VermeulenKirsten/Project1/Coding/templates/img/jpg/ParcelLocker.jpg

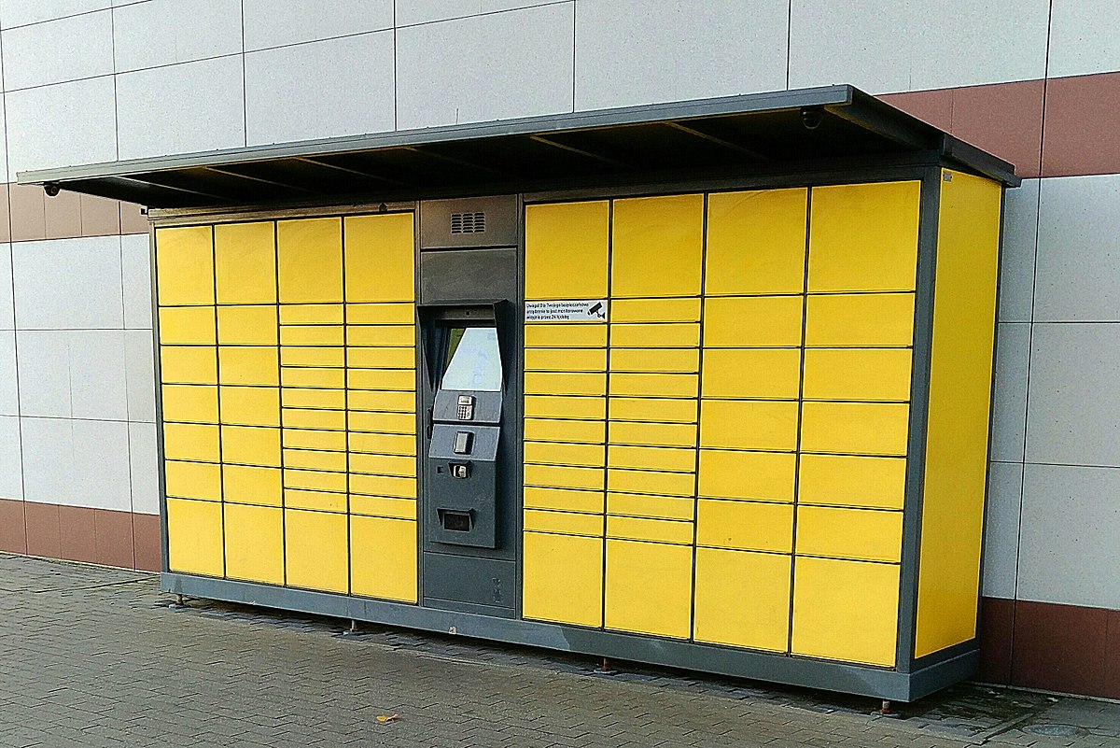
Coding/templates/img/jpg/ParcelLocker.jpg
