VermeulenKirsten/Project1/Coding/templates/img/jpg/user.jpg

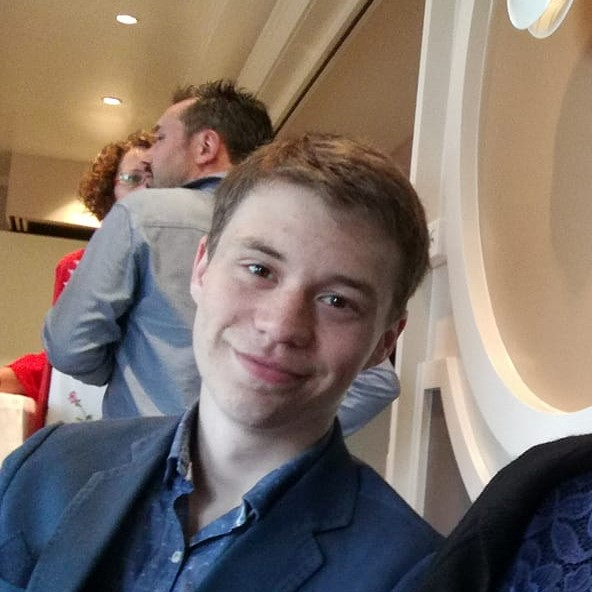
Coding/templates/img/jpg/user.jpg
