VermeulenKirsten/Project1/Milestone 4 Vormstudie/Vormstudie.docx

Vormstudie & productontwikkeling

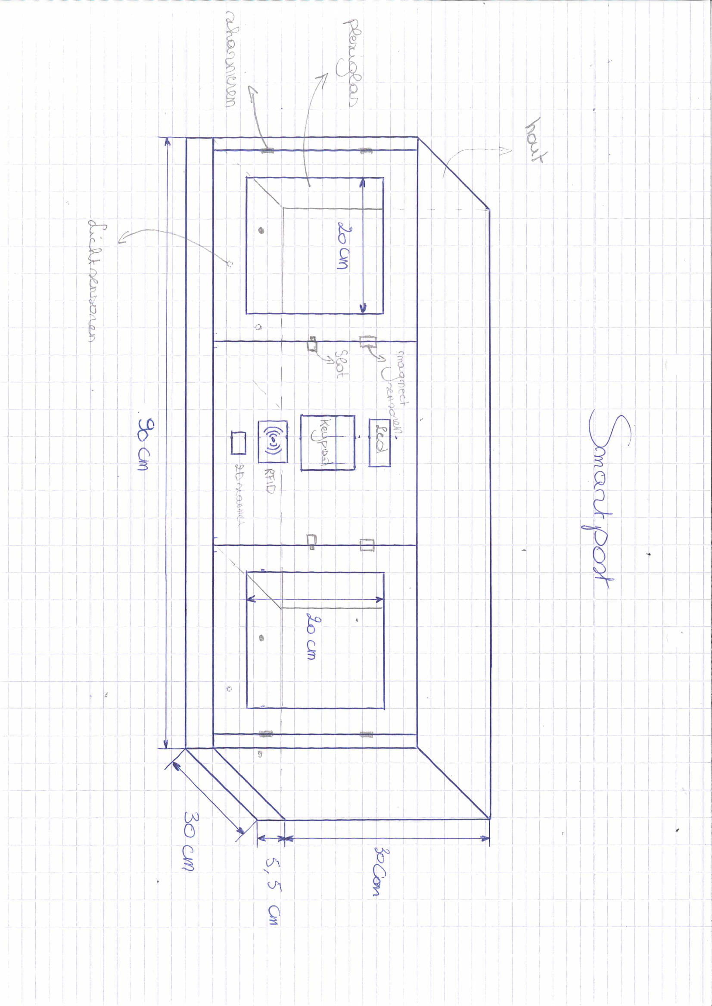
[picture p3: figure]

# Technieken

1. Verzagen
2. Verlijmen
3. lasercutten
