VermeulenKirsten/Project1/Deliverables/Final_poster.pdf

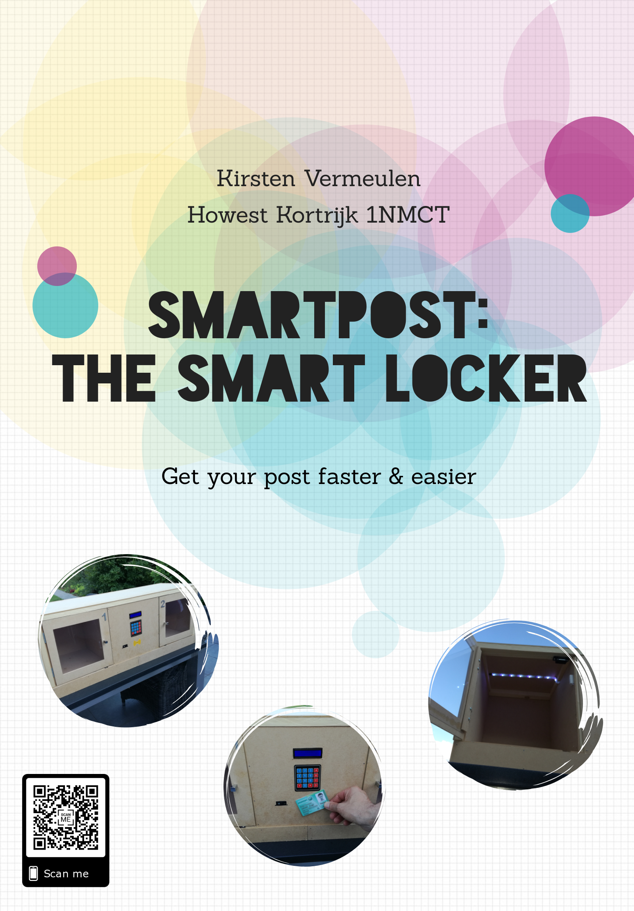
[picture p15: page 1]
