VermeulenKirsten/Project1/Deliverables/Toggl_summary_report.pdf

# Summary Report

### February 13, 2019 – June 17, 2019

TOTAL HOURS: 214:21:25

63.9 h

51.1 h

38.3 h

25.6 h

12.8 h

0.0 h

65:11

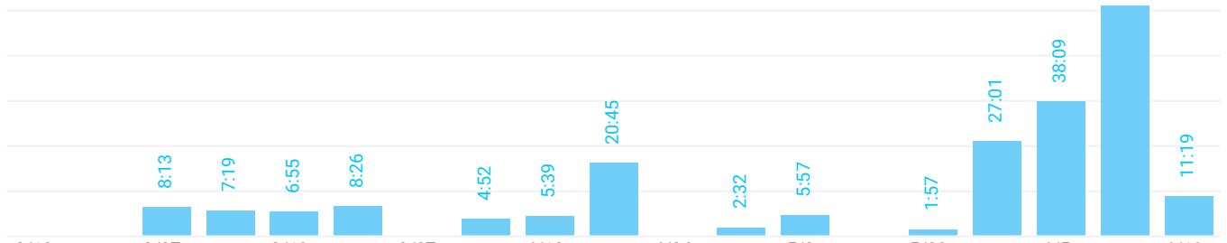
[picture p16: figure]

2/13 -
2/19

2/27 -
3/5

3/13 -
3/19

3/27 -
4/2

4/10 -
4/16

4/24 -
4/30

5/8 -
5/14

5/22 -
5/28

6/5 -
6/11

6/19 -
6/25

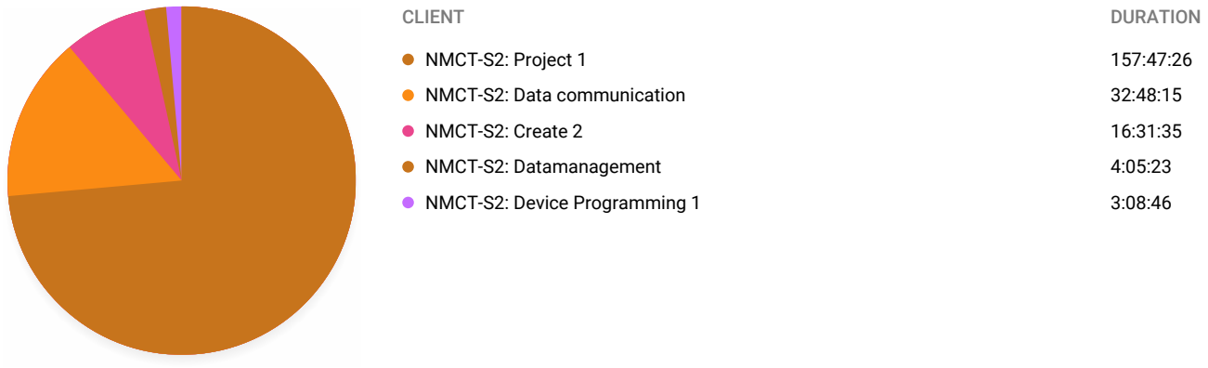
[picture p17: figure]
CLIENT; DURATION; NMCT-S2: Project 1; NMCT-S2: Data communication; NMCT-S2: Create 2; NMCT-S2: Datamanagement; NMCT-S2: Device Programming 1
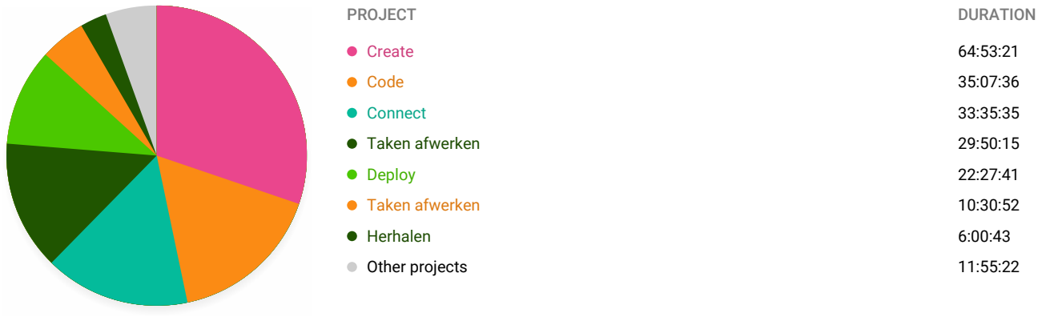
[picture p18: figure]
PROJECT; DURATION; Create; Code; Connect; Taken afwerken; Deploy; Herhalen; Other projects

Kirsten Vermeulen's workspace | Page 1/2

NMCT-S2: Create 2 | 16:31:35
Herhalen | 6:00:43
Taken afwerken | 10:30:52
NMCT-S2: Data communication | 32:48:15
Herhalen | 2:58:00
Taken afwerken | 29:50:15
NMCT-S2: Datamanagement | 4:05:23
Taken afwerken | 4:05:23
NMCT-S2: Device Programming 1 | 3:08:46
Herhalen | 3:08:46
NMCT-S2: Project 1 | 157:47:26
Code | 35:07:36
Connect | 33:35:35
Consult | 1:43:13
Create | 64:53:21
Deploy | 22:27:41
Created with toggl.com | Page 2/2
CLIENT - PROJECT | DURATION

Kirsten Vermeulen's workspace
