VermeulenKirsten/Project1/Milestone 1 Fritzing/Final_Fritzing_Breadboard.pdf

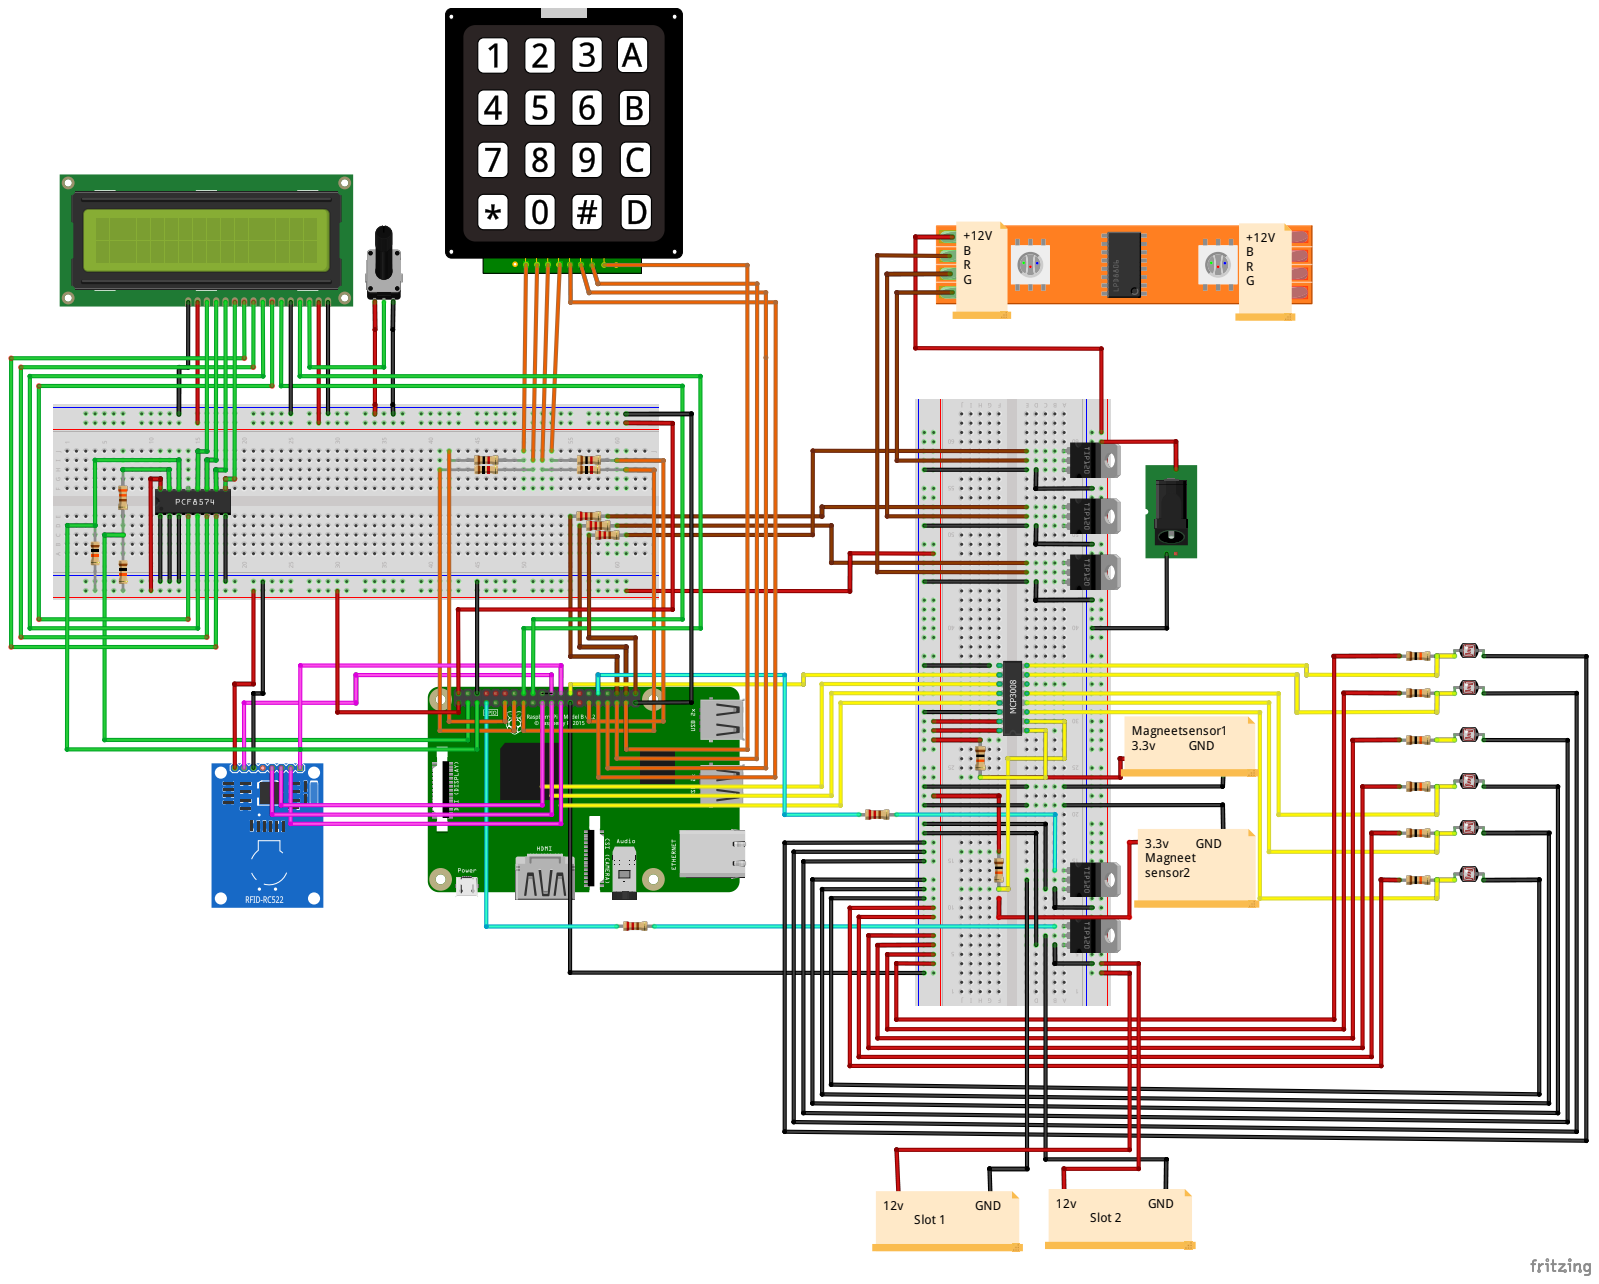
[picture p19: page 1]
Magneetsensor1; GND; Magneet sensor2; Slot 2; Slot 1
