VermeulenKirsten/Project1/Milestone 1 Fritzing/Final_Fritzing_Schema.pdf

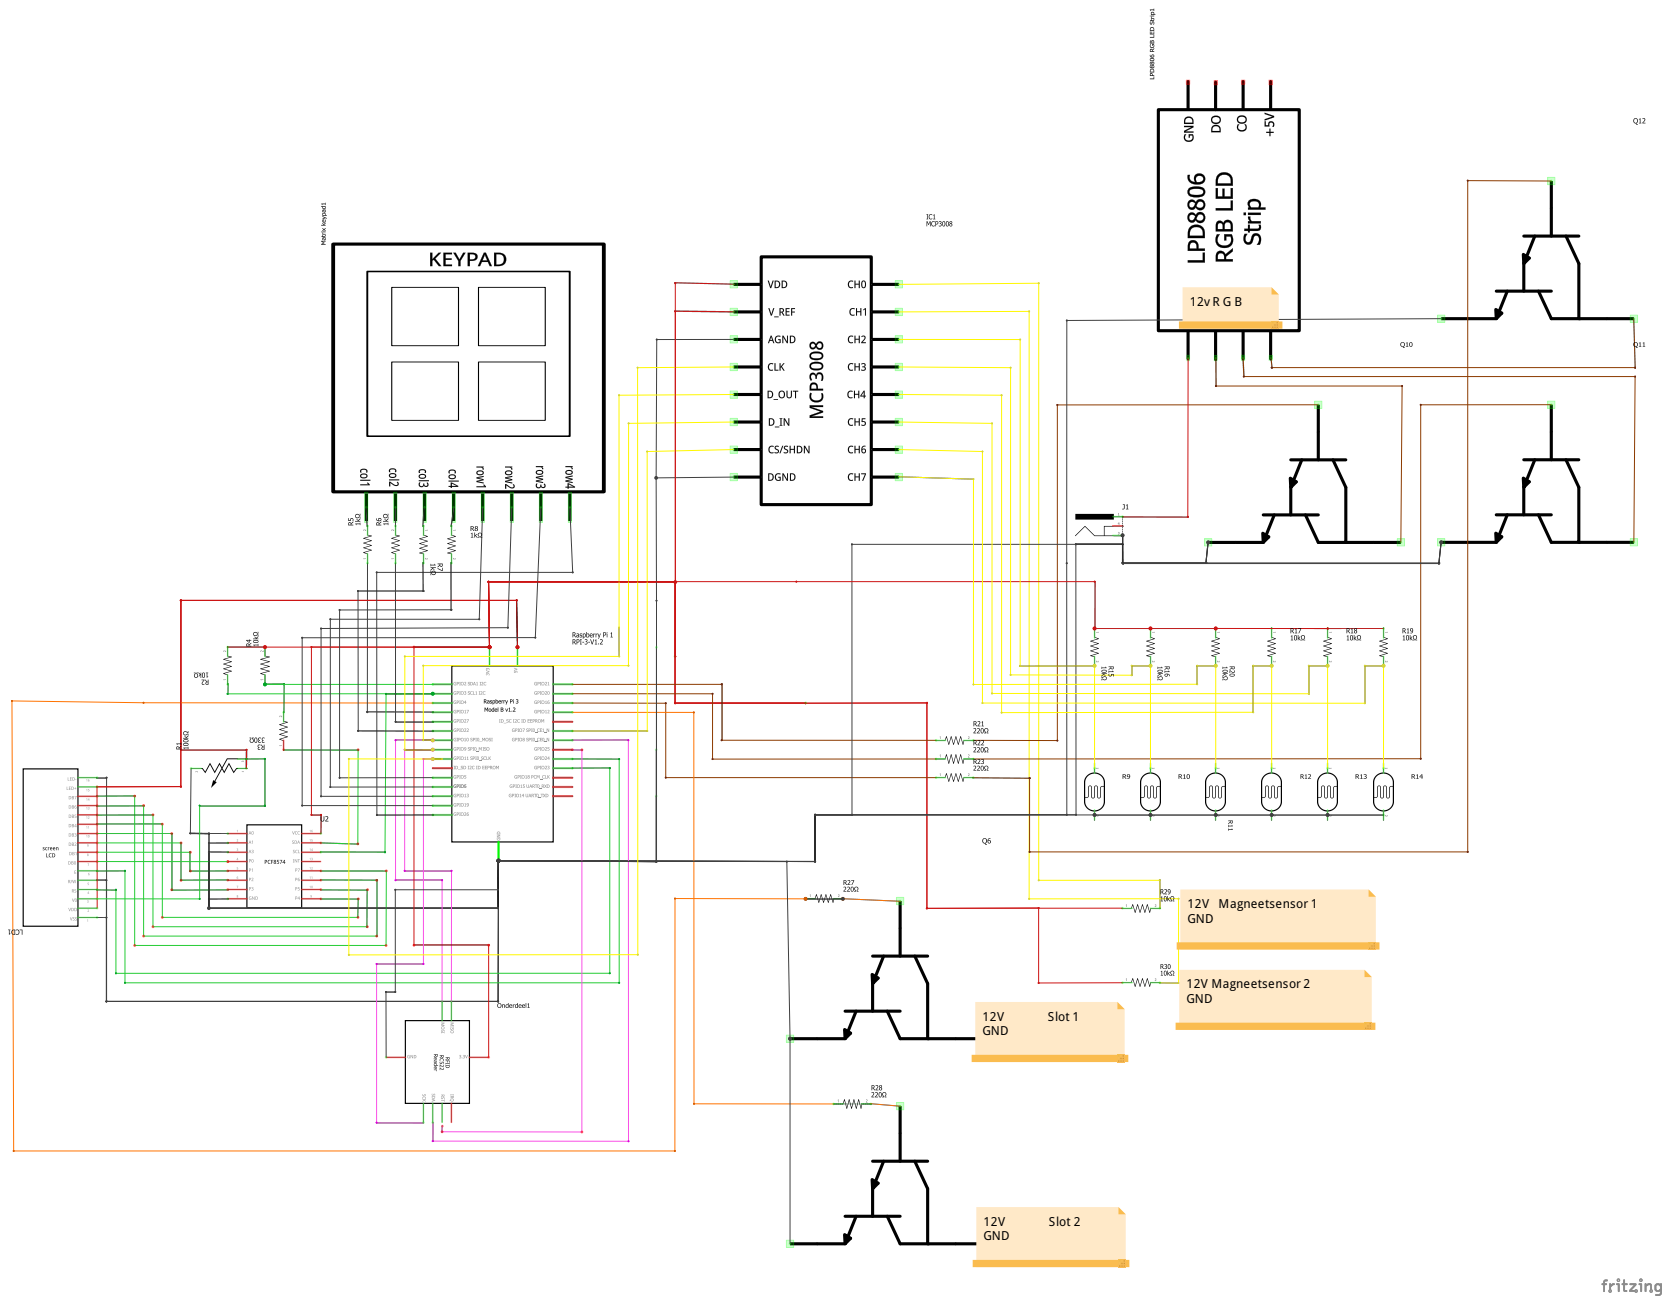
[picture p20: page 1]
Slot 2; GND; Slot 1; 12V Magneetsensor 1 GND; 12V Magneetsensor 2 GND
