VermeulenKirsten/Project1/Milestone 1 Fritzing/FritzingSchemaBreadboardV4.pdf

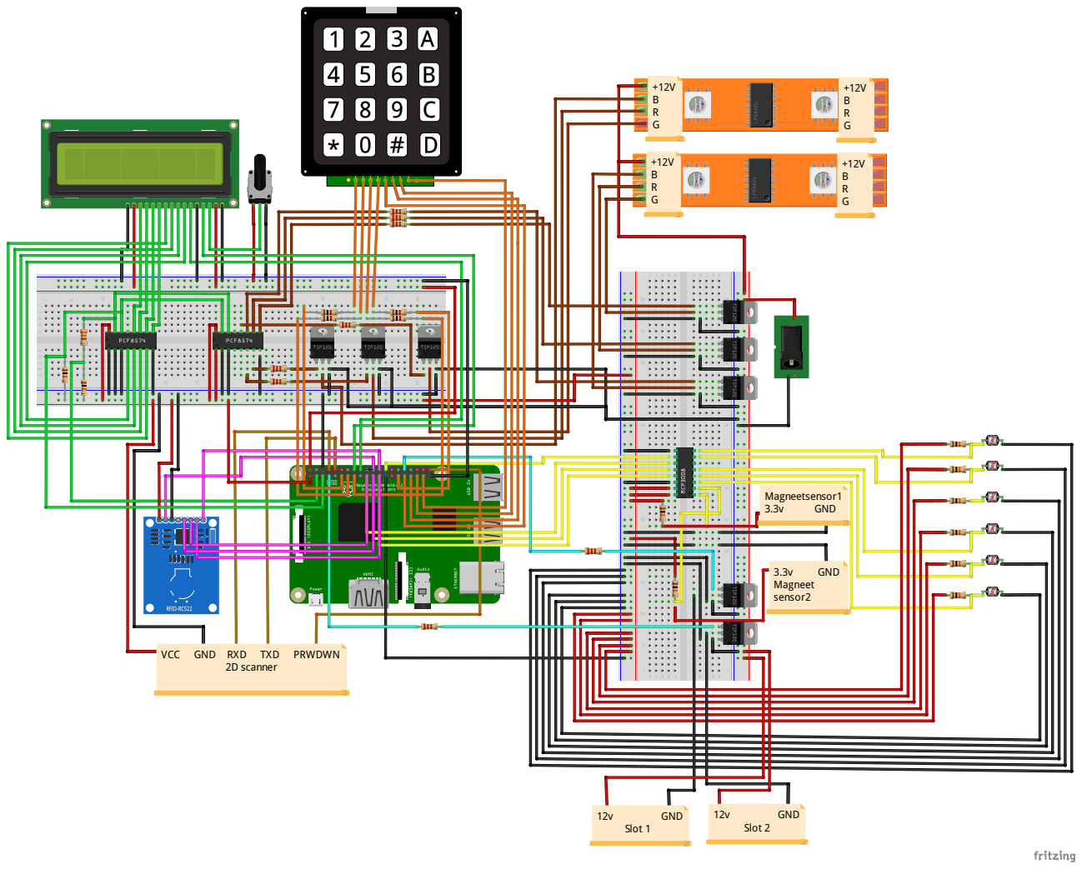
[picture p21: page 1]
VCC; GND RXD; TXD; PRWDWN; 2D scanner; Magneetsensor1; GND; Magneet sensor2; Slot 2; Slot 1
