VermeulenKirsten/Project1/Milestone 1 Fritzing/FritzingSchemaV4.pdf

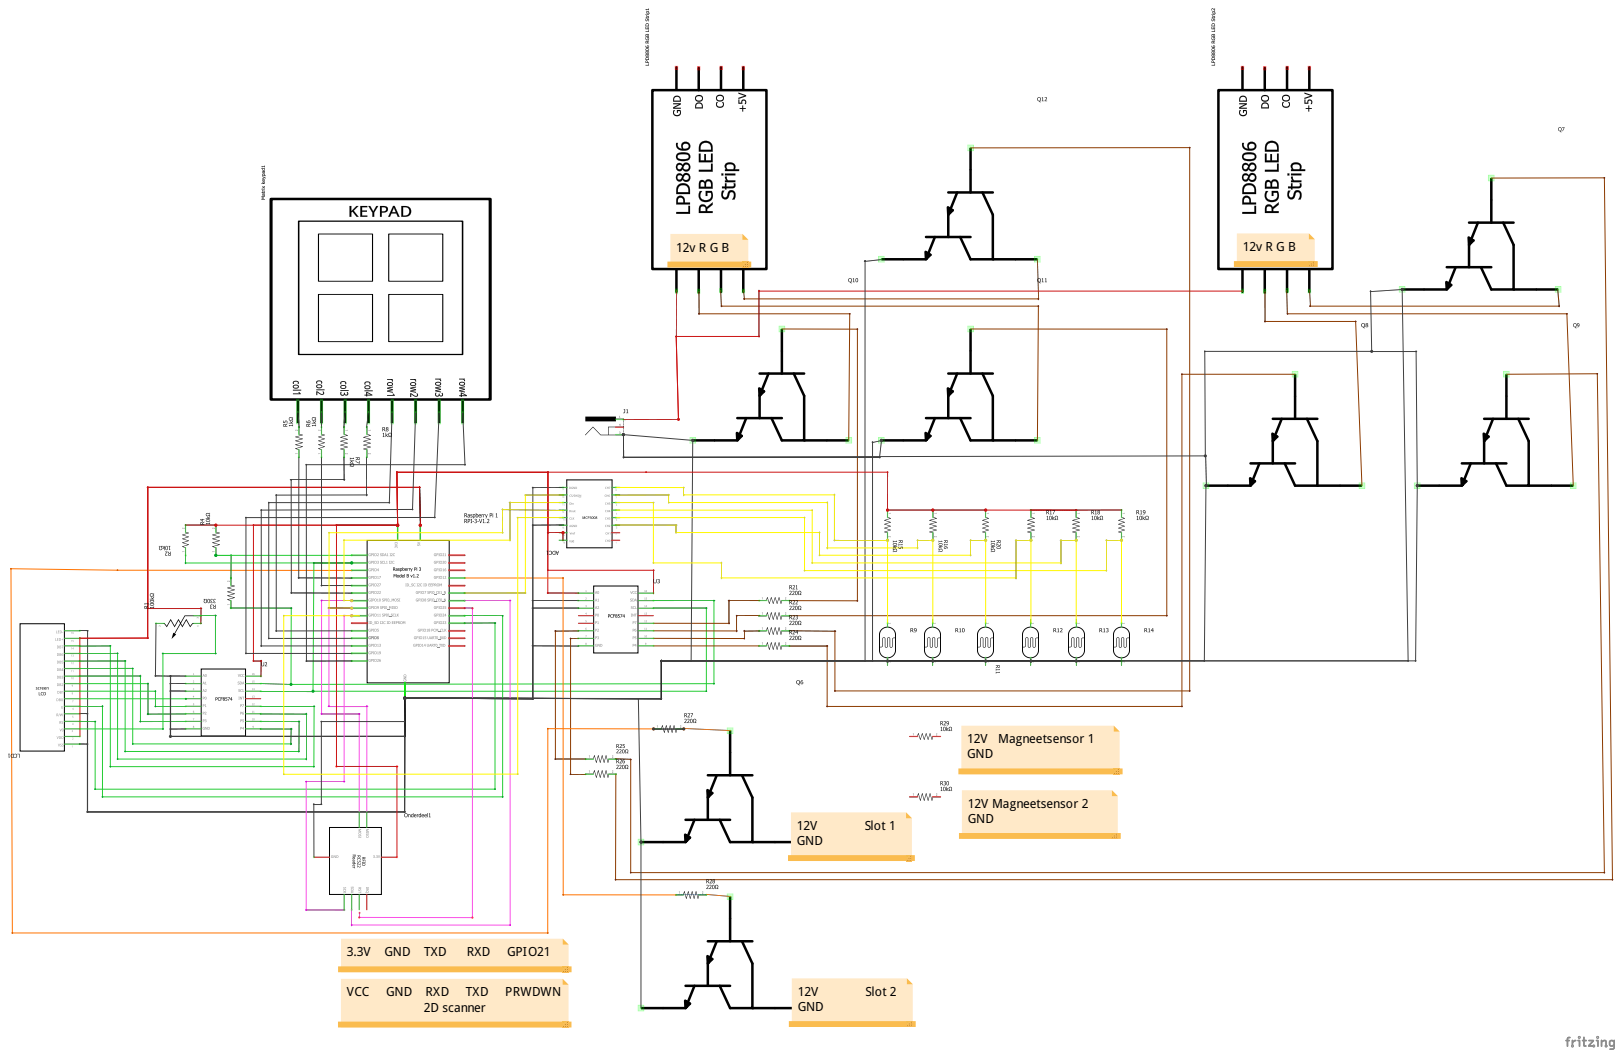
[picture p22: page 1]
VCC; GND RXD; TXD; PRWDWN; 2D scanner; 3.3V GND TXD; RXD; GPIO21; Slot 2; GND; Slot 1; 12V Magneetsensor 1 GND; 12V Magneetsensor 2 GND
