VermeulenKirsten/Project1/(list of files, drawings)

Other design files:
Milestone 1 Fritzing/Final_Fritzing_Breadboard.fzz
Milestone 1 Fritzing/Final_Fritzing_Schema.fzz
Milestone 1 Fritzing/FritzingSchemaBreadboardV4.fzz
Milestone 1 Fritzing/FritzingSchemaV4.fzz
