VermeulenKirsten/Project1/(commit log)

2019-06-17 Adding all endcompetentions
    [Final_Fritzing_Breadboard.fzz, Final_Fritzing_Schema.fzz, FritzingSchemaBreadboardV4.fzz, FritzingSchemaV4.fzz]
2019-06-17 Adding code with small bugs
    [Database.py, Keypad.py, LCDDisplay.py, Ledstrip.py, Lock.py, MCP3008.py, PCF8574.py, SimpleMFRC522.py]
